omprakashrajp75-ui/DeskSense-V3/DeskSense_GTM_Strategy.pptx

CORE THESIS

Prove value in one GCC.
Convert evidence into paid deployments.
Scale through trusted channels.

GO-TO-MARKET
STRATEGY

DeskSense

Privacy-first AIoT workplace wellness

GCC-first • Design-partner-led • Evidence-driven

AIoT Design Challenge 2026 | National Grand Finale

DESKSENSE • GTM STRATEGY

## Slide 2

01 | OPPORTUNITY

The market problem creates a focused entry point

02

66%

Pooled prevalence of work-related musculoskeletal pain among Indian IT professionals.

Why GCCs first?

2.36M

Employees in Indian Global Capability Centres (GCCs) — the proposed beachhead.

₹300

Proposed monthly price per monitored desk; commercial willingness to pay is unvalidated.

ENTRY STRATEGY

Start with one GCC in Coimbatore or Bengaluru—not the entire office market.

• Enterprise facilities and occupational-health stakeholders
• Multinational privacy and security expectations
• Potential to expand from one site to multiple desks and locations

Source: DeskSense Business Model & Market Case; figures are source-document estimates.

DESKSENSE • GTM STRATEGY

## Slide 3

02 | POSITIONING

Position DeskSense around privacy + ergonomics

03

POSITIONING

Differentiation

Edge processing

Vision inference runs locally.

Workplace ergonomics insights without sending employee video to the cloud.

Independent device

No corporate laptop agent required.

TRUST IS A PRODUCT REQUIREMENT

Verify data flows, access controls and network behavior before making absolute privacy claims.

Physical controls

Relays can interface with desk equipment.

Enterprise reporting

Aggregate ergonomics and utilization insights.

DESKSENSE • GTM STRATEGY

## Slide 4

03 | CUSTOMER & ACQUISITION

Sell to EHS / Facilities; engage HR and IT early

04

PRIMARY BUYER

EHS Head or Facilities Head
Owns workplace health / facilities priorities.

Enterprise acquisition funnel

INFLUENCERS / VETO

HR, IT Security, Data Protection
Address acceptance and privacy before pilot.

INITIAL CUSTOMER

GCC with fixed-desk workers
Start with 25 desks at one site.

Identify

Qualify GCC accounts

01

Demonstrate

Show live system + privacy design

02

Pilot

25 desks; agree on metrics

03

Prove

Baseline vs. endline evidence

04

Convert

Paid three-year contract

05

Core sales message: wellbeing and ergonomics—not employee surveillance.

DESKSENSE • GTM STRATEGY

## Slide 5

04 | BUSINESS MODEL

Recurring revenue through Hardware-as-a-Service

05

₹300

per desk / month

₹10,800 total contract revenue
per desk over 36 months

Illustrative unit economics

₹3,600

Annual revenue / desk

₹4,850

Estimated production hardware cost

55%

Hardware-level gross margin before support costs

Aggregate ergonomics reporting • Workplace occupancy / utilization analytics

Estimated hardware payback

Caveat: ₹300 pricing and ₹4,850 BOM are proposed / estimated—not validated quotes. Full service costs are excluded.

DESKSENSE • GTM STRATEGY

Potential expansion revenue

~16 mo

## Slide 6

05 | EXECUTION

A 12-month roadmap from proof to repeatable sales

06

DESIGN PARTNER

1 site • 25 desks

• Secure one GCC partner
• Install and establish baseline
• Agree evaluation + data governance

PHASE 1

MONTHS 1–3

PROOF & CONVERSION

3 sites • 400 desks

• Complete endline evaluation
• Publish approved case study
• Convert pilot; approach 2 GCCs

PHASE 2

MONTHS 4–6

CHANNEL SCALE

10 sites • 2,500 desks

• Partner with EHS consultancies
• Engage ISO 45001 auditors
• Standardize deployment + support

PHASE 3

MONTHS 7–12

Targets are planning assumptions from the source document; they are not achieved results.

DESKSENSE • GTM STRATEGY

## Slide 7

06 | MARKET POTENTIAL

Bottom-up market sizing and revenue ambition

07

TAM

5.8M employees

₹2,088 crore

India technology workforce

YEAR-ONE TARGET

2,500

active paid desks

₹90 lakh

annualized subscription run rate

SAM

2.36M employees

₹850 crore

Indian GCC workforce

SOM • Year 3

47,000 desks

₹17 crore

2% of SAM, at proposed pricing

Assumes all 2,500 desks are active and paying at ₹3,600/year. This is not first-year recognized revenue.

DESKSENSE • GTM STRATEGY

## Slide 8

07 | TRUST & IMPACT

Build trust, measure impact, manage execution risk

08

PRIVACY

Verify no outbound imagery; explain what is detected, stored and shared.

EVIDENCE

Measure baseline vs. endline; report reliability and sustained use.

ECONOMICS

Validate BOM with supplier quotes; include support, warranty and acquisition costs.

Contractual impact model

10 paid desks

Priority beneficiaries

Government engineering colleges
Public libraries / study centres
NGO-run skilling centres

→

1 free institutional desk

Track deployments, 90-day posture-score change, 6-month sustained use and district reach.

DESKSENSE • GTM STRATEGY

## Slide 9

08 | KPIS & NEXT STEPS

Measure what proves product-market fit

09

COMMERCIAL

• Paid desks & sites
• Pilot-to-paid conversion
• Sales cycle
• Customer acquisition cost

PRODUCT

• Detection reliability
• Device uptime
• Sustained-use rate
• Privacy verification

FINANCIAL

• Actual BOM
• Contribution margin / desk
• Support cost
• Renewal / expansion

1) Secure a GCC design partner 2) Agree measurable pilot outcomes 3) Validate pricing and production cost

GTM thesis: one credible deployment → evidence → paid conversion → channel-led scale.

DESKSENSE • GTM STRATEGY

IMMEDIATE PRIORITIES
