omprakashrajp75-ui/DeskSense-V3/desksense_v3_bottom_panel_with_unoq_standoffs.stl

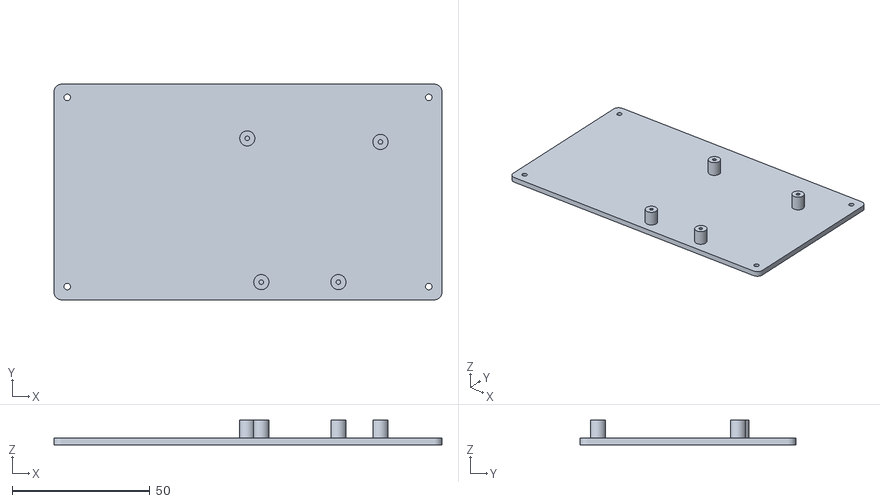
[picture p4: CAD file, 2026-10-15]
desksense_v3_bottom_panel_with_unoq_standoffs.stl
140.6 x 78.2 x 8.90
