omprakashrajp75-ui/DeskSense-V3/desksense_v3_display_clamp_bar.stl

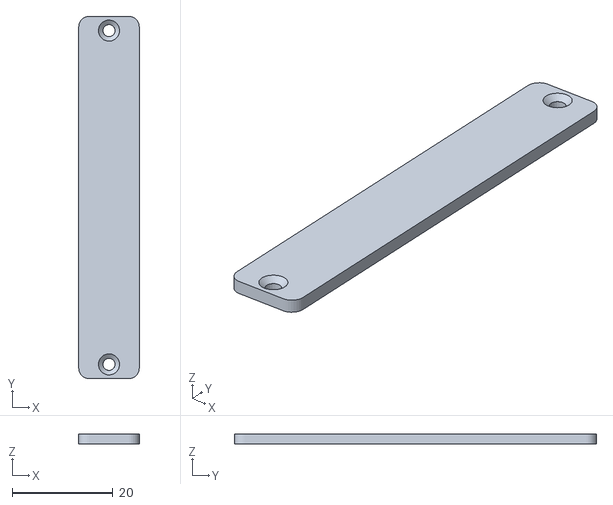
[picture p5: CAD file, 2026-10-15]
desksense_v3_display_clamp_bar.stl
12.0 x 71.8 x 2.00
