omprakashrajp75-ui/DeskSense-V3/desksense_v3_body.stl

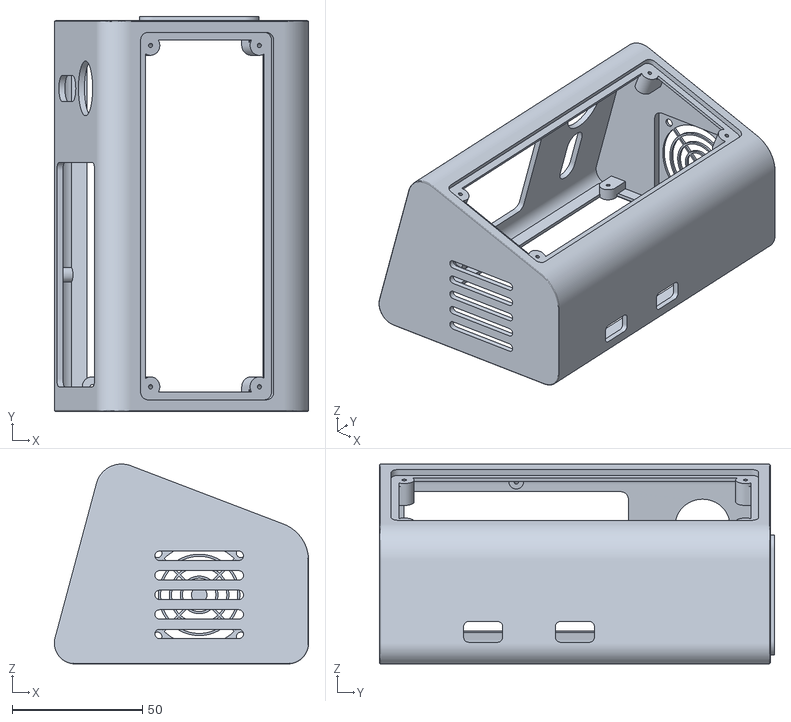
[picture p6: CAD file, 2026-10-15]
desksense_v3_body.stl
97.6 x 151.6 x 76.7
