omprakashrajp75-ui/DeskSense-V3/desksense_v3_led_diffuser_1.stl

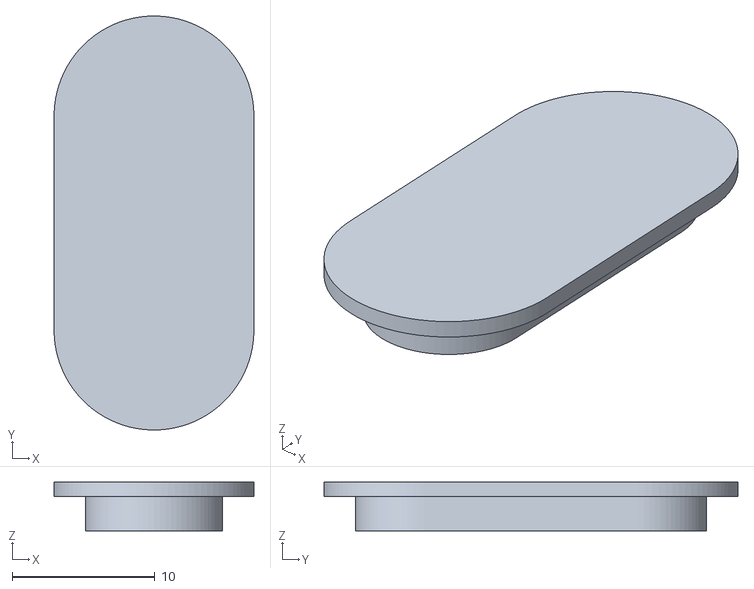
[picture p7: CAD file, 2026-10-15]
desksense_v3_led_diffuser_1.stl
14.0 x 29.0 x 3.40
