omprakashrajp75-ui/DeskSense-V3/desksense_v3_top_panel.stl

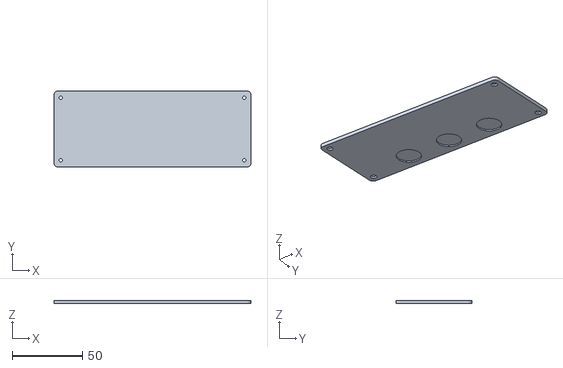
[picture p8: CAD file, 2026-10-15]
desksense_v3_top_panel.stl
140.6 x 54.3 x 2.40
